gregerw/Split-flap-display/README.md

# Split-flap-display
Self-made split flap display

Find instructions how to build display at https://wordpress.com/view/splitflap.home.blog
