gregerw/Split-flap-display/CAD/flaps/flapsPlateBackside.jpg

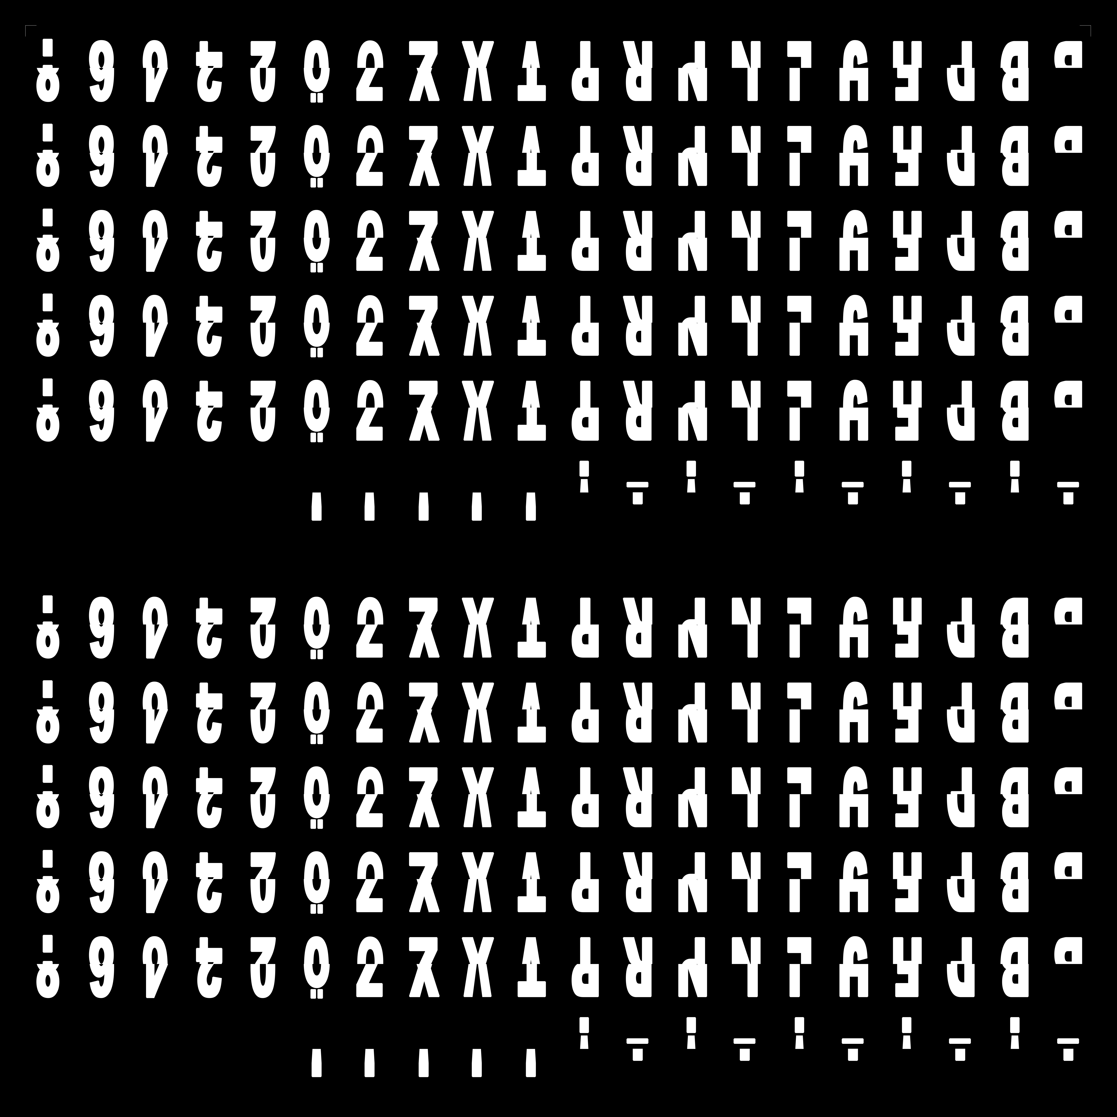
CAD/flaps/flapsPlateBackside.jpg
