gregerw/Split-flap-display/CAD/flaps/flapsPlateFrontside.jpg

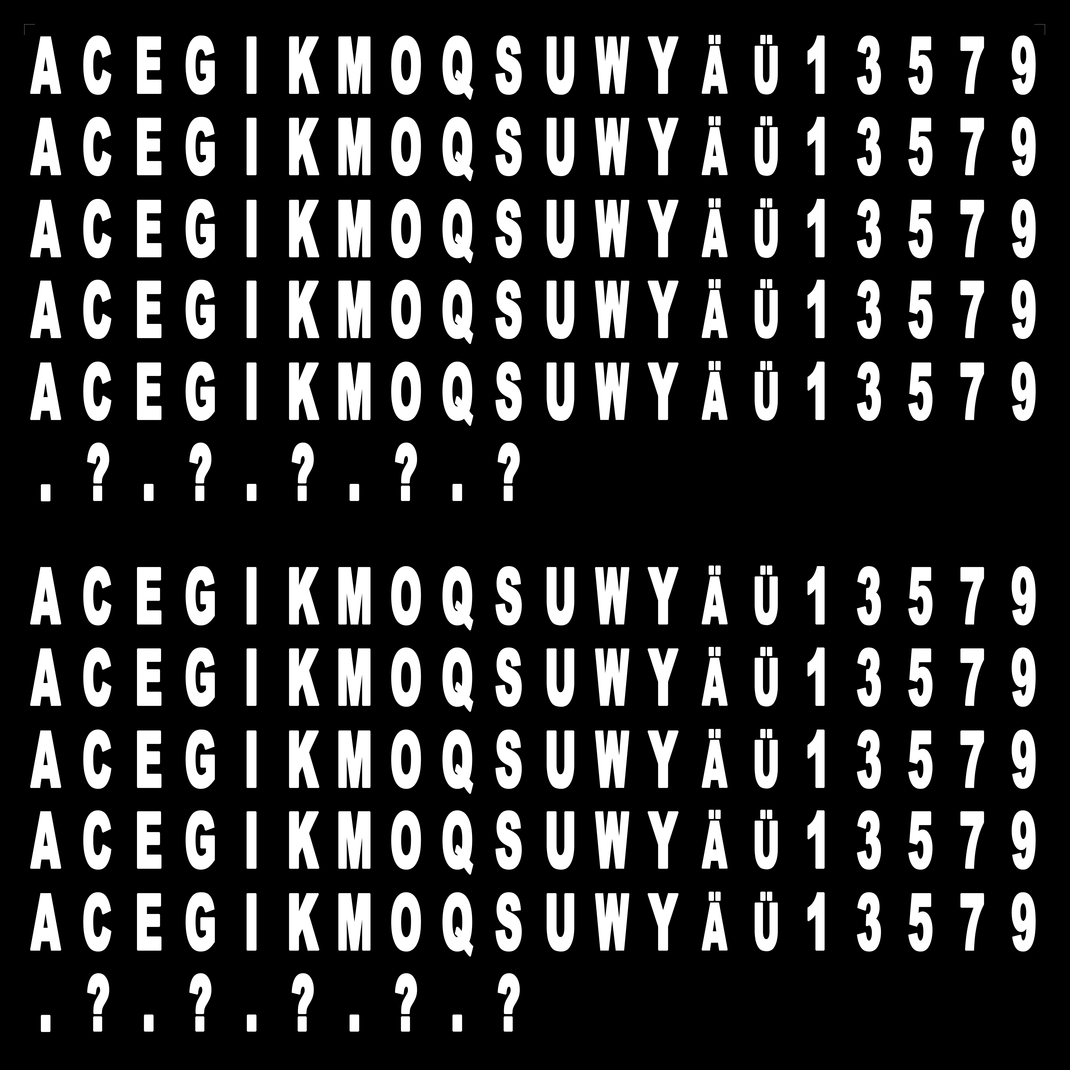
CAD/flaps/flapsPlateFrontside.jpg
