gregerw/Split-flap-display/BOM_split_flap.xlsx

Sheet: BOM_unit
Part | Part-No. | Manufacturer | Amount | Price | Reseller | Purpose of part
Step motor | 28BYJ48 12V | - | 1 | 1.19 € | https://www.aliexpress.com/item/28BYJ-48-DC-12V-Reduction-Step-Gear-Stepper-Motor-4-Phase-28byj-28byj48-for-arduino-Diy/32959155187.html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 | Rotate the revolver
Microcontroller | ATmega328P | ATMEL | 1 | 1.73 € | https://www.aliexpress.com/item/Mini-USB-Nano-V3-0-ATmega328P-CH340G-5V-16M-Micro-controller-board-for-arduino-NANO-328P/32951657212.html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 | Controller for one module/unit
PCB | unit_pcb.zip | - | 1 | 0.50 € | https://www.elecrow.com | PCB for unit
Darlington Array | ULN2003A | ST | 1 | 0.30 € | https://www.reichelt.de/darlington-arrays-konstantstromregler-dip-16-uln-2003a-p22069.html?trstct=pos_7 | Driver for stepmotor
Hall-Sensor-Module | KY-003 | Eichip | 1 | 0.17 € | https://www.aliexpress.com/item/Free-shipping-1pcs-lot-Standard-Hall-Magnetic-Sensor-Module-for-Arduino-AVR-PIC-Good-KY-003/32661635775.html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 | Angle calibration
Neodym Magnet 2mmx 1mm | F321-50 N42 | First4magnets | 1 | 0.13 € | https://www.amazon.de/dp/B007JTKHR6/ref=pe_3044161_189395811_TE_SCE_dp_2 | Magnet to calibrate rotation
DC-DC 5V | L7805CV-DG STM | Hottech | 1 | 0.27 € | https://www.reichelt.de/spannungsregler-fest-4-8-5-2-v-to-220-a-7805-p23443.html?&trstct=pos_1 | DC-DC converter 5V
Connector female | JST PH2P BU | JST | 2 | 0.05 € | https://www.reichelt.de/jst-buchsengehaeuse-1x2-polig-ph-jst-ph2p-bu-p185041.html?&trstct=pos_0 | Connector to I2C
Connector male | JST PH2P ST | JST | 2 | 0.10 € | https://www.reichelt.de/jst-stiftleiste-gerade-1x2-polig-ph-jst-ph2p-st-p185049.html?&trstct=pos_0 | Connector to I2C
Connector female | JST XH5P BU | JST | 1 | 0.04 € | https://www.reichelt.de/jst-buchsengehaeuse-1x5-polig-xh-jst-xh5p-bu-p185088.html?&trstct=pos_2 | Connector Hall-Sensor and Thermistor
Connector male | JST XH5P ST | JST | 1 | 0.17 € | https://www.reichelt.de/jst-stiftleiste-gerade-1x5-polig-xh-jst-xh5p-st-p185076.html?&trstct=pos_0 | Connector Hall-Sensor and Thermistor
Crimp for XH | JST XH CKB JST | JST | 5 | 0.03 € | https://www.reichelt.de/jst-crimpkontakt-buchse-xh-jst-xh-ckb-p185091.html?trstct=lsbght_sldr::185088 | Crimp for XH connectors
Crimp for PH | JST PH CKB | JST | 4 | 0.06 € | https://www.reichelt.de/jst-crimpkontakt-buchse-ph-jst-ph-ckb-p185071.html?&trstct=pos_0 | Crimp for PH connectors
Connector Stepmotor | JST XH5P ST | JST | 1 | 0.22 € | https://www.reichelt.de/jst-stiftleiste-gerade-1x5-polig-xh-jst-xh5p-st-p185076.html?&trstct=pos_0 | Connector to Stepmotor
Connector 12V male | AKL 230-02 | AKL | 1 | 0.28 € | https://www.reichelt.de/wannenstecker-fuer-akl-249-2-pol-rm5-08-akl-230-02-p36701.html? | Connector to 12V
Connector 12V female | AKL 249-02 | AKL | 1 | 0.57 € | https://www.reichelt.de/anschlussklemmensystem-2-pol-rm5-08-akl-249-02-p36686.html?&trstct=pos_0 | Connector to 12V
Thermistor 100K; B3950K | NTC Thermistor 100k B3950K | - | 1 | 0.25 € | https://www.ebay.de/i/112050606664?chn=ps | Thermistor for temperature measurement
Resistor 100k | 100k, 0.6W | - | 1 | 0.04 € | https://www.reichelt.de/duennschichtwiderstand-axial-0-6-w-100-kohm-1-vi-mbb02070c1003-p233667.html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 | Reference resistor for thermistor
Housing Screws, Torx, counter sunk | Screw PT K25, 10 | PT | 15 | 0.06 € | https://www.online-schraubenhandel.de/price.php?group_id=71 | Screws for housing and motorblock
PCBA Screws, Torx, raised head | Screw PT K25, 6 | PT | 4 | 0.14 € | https://www.ebay.de/itm/25-PT-Schrauben-f-Kunststoffe-Linsenkopf-Torx-A2-2-5X6-Thermoplaste-rostfrei/401004178857 | Screws to fix the PCBA on the rear side
Front-Panel | front_panel.gcode | - | 1 | 0.17 € | https://www.amazon.de/ELEGOO-Filament-Drucker-Printer-Toleranz/dp/B07K1MCSCQ | Plastic parts printed via e.g. Anycubic i3
Rear-Panel | rear_panel.gcode | - | 1 | 0.19 € | https://www.amazon.de/ELEGOO-Filament-Drucker-Printer-Toleranz/dp/B07K1MCSCQ | Plastic parts printed via e.g. Anycubic i3
Left-Panel | left_panel.gcode | - | 1 | 0.34 € | https://www.amazon.de/ELEGOO-Filament-Drucker-Printer-Toleranz/dp/B07K1MCSCQ | Plastic parts printed via e.g. Anycubic i3
Right-Panel | right_panel.gcode | - | 1 | 0.32 € | https://www.amazon.de/ELEGOO-Filament-Drucker-Printer-Toleranz/dp/B07K1MCSCQ | Plastic parts printed via e.g. Anycubic i3
Motorblock | motorblock.gcode | - | 1 | 0.22 € | https://www.amazon.de/ELEGOO-Filament-Drucker-Printer-Toleranz/dp/B07K1MCSCQ | Plastic parts printed via e.g. Anycubic i3
Revolver Left | revolver_left.gcode | - | 1 | 0.27 € | https://www.amazon.de/ELEGOO-Filament-Drucker-Printer-Toleranz/dp/B07K1MCSCQ | Plastic parts printed via e.g. Anycubic i3
Revolver Right | revolver_right.gcode | - | 1 | 0.51 € | https://www.amazon.de/ELEGOO-Filament-Drucker-Printer-Toleranz/dp/B07K1MCSCQ | Plastic parts printed via e.g. Anycubic i3
Flaps | flaps.pdf, flaps.svg | - | 45 | 0.10 € | http://xlprint24.de | Polypropylene 1mm plate, printed both sides; Lasercutted
 |  | Total costs per unit |  | 14.47 €

Sheet: BOM_master
Part | Part-No. | Manufacturer | Amount | Price | Reseller | Purpose of part
Microcontroller | ATmega328P | ATMEL | 1 | 1.73 € | https://www.aliexpress.com/item/Mini-USB-Nano-V3-0-ATmega328P-CH340G-5V-16M-Micro-controller-board-for-arduino-NANO-328P/32951657212.html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 | Controller for master
Wifi-Module | ESP8266 ESP01 | Espressif | 1 | 1.23 € | https://www.aliexpress.com/item/Free-Shipping-ESP8266-ESP-01S-ESP-01-Wireless-Transceiver-Module-With-Breakout-Breadboard-Adapter/32770549691.html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 | Wifi-module
PCB | master_pcb.zip | - | 1 | 0.50 € | https://www.elecrow.com | PCB for master
DC-DC 5V | L7805CV-DG STM | Hottech | 1 | 0.27 € | https://www.reichelt.de/spannungsregler-fest-4-8-5-2-v-to-220-a-7805-p23443.html?&trstct=pos_1 | 5V for Arduino and for DC-DC 3,3V
DC-DC 3,3V | LM3940 | TI | 1 | 1.40 € | https://www.reichelt.de/ldo-regler-fest-3-3-v-to-220-lm-3940-it3-3-p39464.html? | 3,3V for ESP8266
MOSFET | 2N7000 | UTC | 2 | 0.09 € | https://www.reichelt.de/mosfet-n-ch-60v-0-115a-0-4w-to-92-2n-7000-p41141.html? | Part of the 5V/3,3V bidirectional level shifter
Resistor 4,7k 0207 | 4k7, 0207 | - | 2 | 0.08 € | https://www.reichelt.de/widerstand-metallschicht-4-75-kohm-0207-0-6-w-1-metall-4-75k-p11786.html? | Part of the 5V/3,3V bidirectional level shifter
Resistor 2k 0207 | 2k, 0207 |  | 2 | 0.08 € | https://www.reichelt.de/widerstand-metallschicht-2-00-kohm-0207-0-6-w-1--metall-2-00k-p11578.html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 | Pull-up for I2C
Resistor 10k 0207 | 10k, 0207 | - | 4 | 0.08 € | https://www.reichelt.de/widerstand-metallschicht-10-0-kohm-0207-0-6-w-1-metall-10-0k-p11449.html? | Part of the 5V/3,3V bidirectional level shifter
Capacitor 100nF | X7R-5 100N | - | 2 | 0.10 € | https://www.reichelt.de/vielschicht-keramikkondensator-100n-10-x7r-5-100n-p22865.html?&trstct=pos_0 | Capacitor to stabalize supply voltage
Connector male | JST PH2P ST | JST | 2 | 0.10 € | https://www.reichelt.de/jst-stiftleiste-gerade-1x2-polig-ph-jst-ph2p-st-p185049.html?&trstct=pos_0 | Connector to I2C
Connector 12V male | AKL 230-02 | AKL | 1 | 0.28 € | https://www.reichelt.de/wannenstecker-fuer-akl-249-2-pol-rm5-08-akl-230-02-p36701.html? | Connector to 12V
Connector 12V female | AKL 249-02 | AKL | 1 | 0.57 € | https://www.reichelt.de/anschlussklemmensystem-2-pol-rm5-08-akl-249-02-p36686.html?&trstct=pos_0 | Connector to 12V
 |  | Total costs per unit |  | 7.20 €
