gregerw/Split-flap-display/CAD/housing_side_right.STL

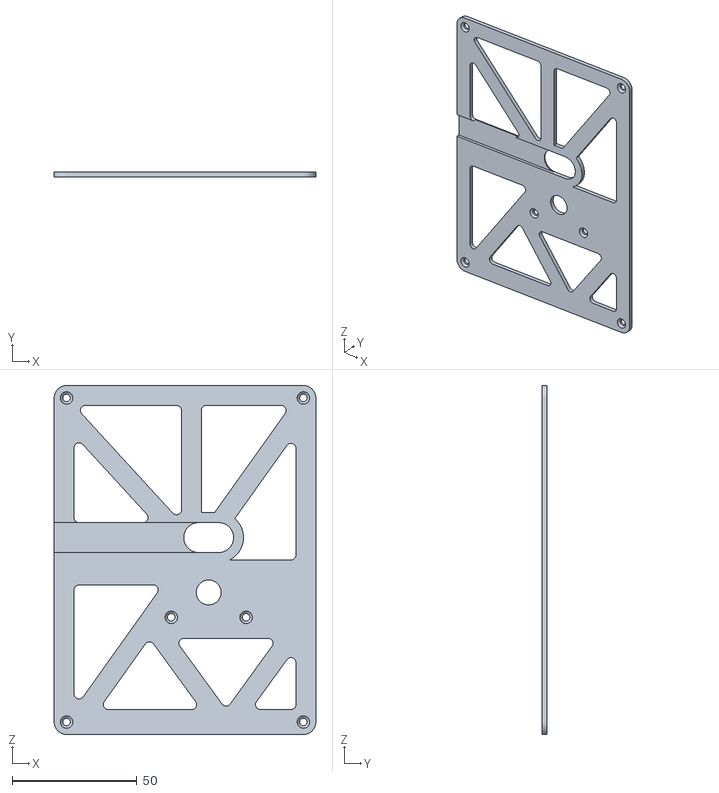
[picture p3: CAD file, 2019-05-17]
CAD/housing_side_right.STL
105.0 x 2.00 x 140.0
