gregerw/Split-flap-display/CAD/motorblock.STL

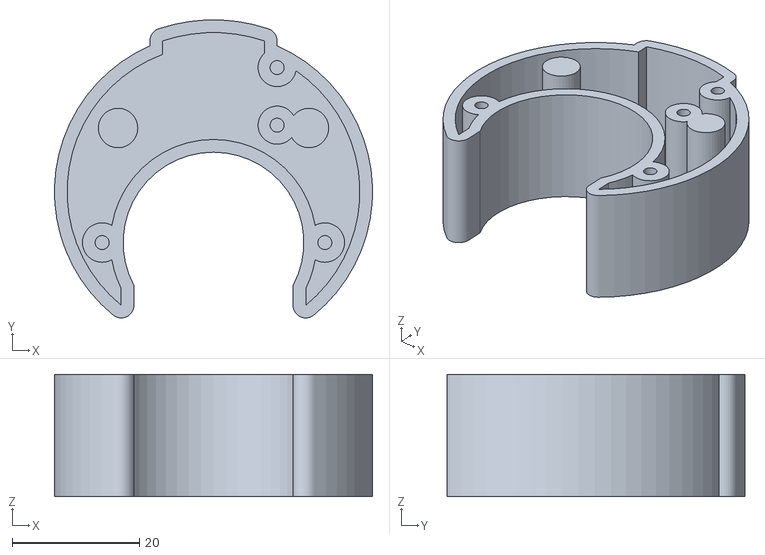
[picture p4: CAD file, 2019-05-17]
CAD/motorblock.STL
50.0 x 46.8 x 19.2
