gregerw/Split-flap-display/CAD/revolver_left.STL

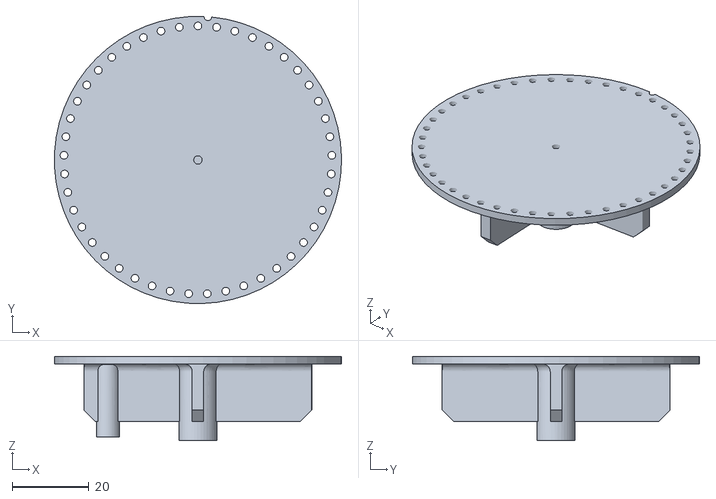
[picture p5: CAD file, 2019-05-17]
CAD/revolver_left.STL
74.9 x 74.9 x 22.0
