gregerw/Split-flap-display/CAD/revolver_right.STL

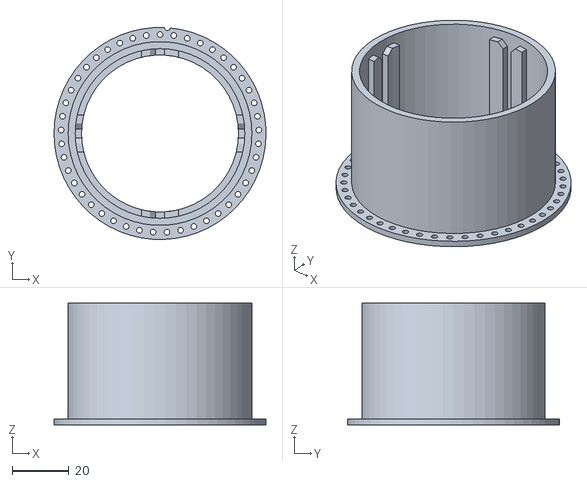
[picture p6: CAD file, 2019-05-17]
CAD/revolver_right.STL
75.0 x 74.9 x 43.0
