gregerw/Split-flap-display/CAD/housing_front.STL

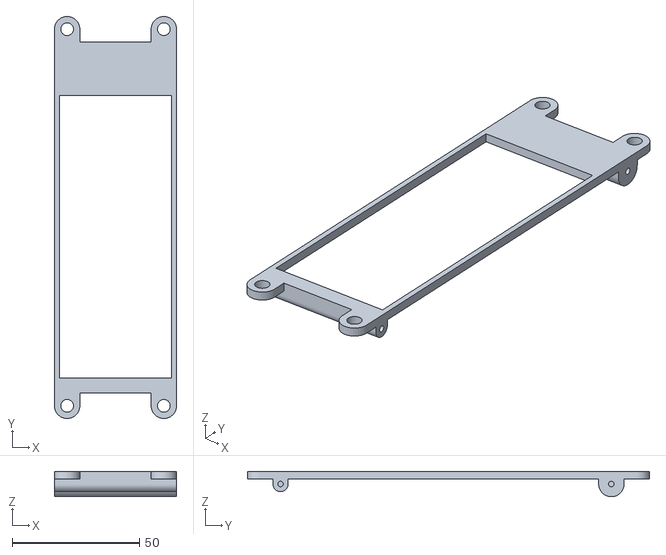
[picture p7: CAD file, 2019-05-17]
CAD/housing_front.STL
48.0 x 158.0 x 9.98
