gregerw/Split-flap-display/CAD/housing_back.STL

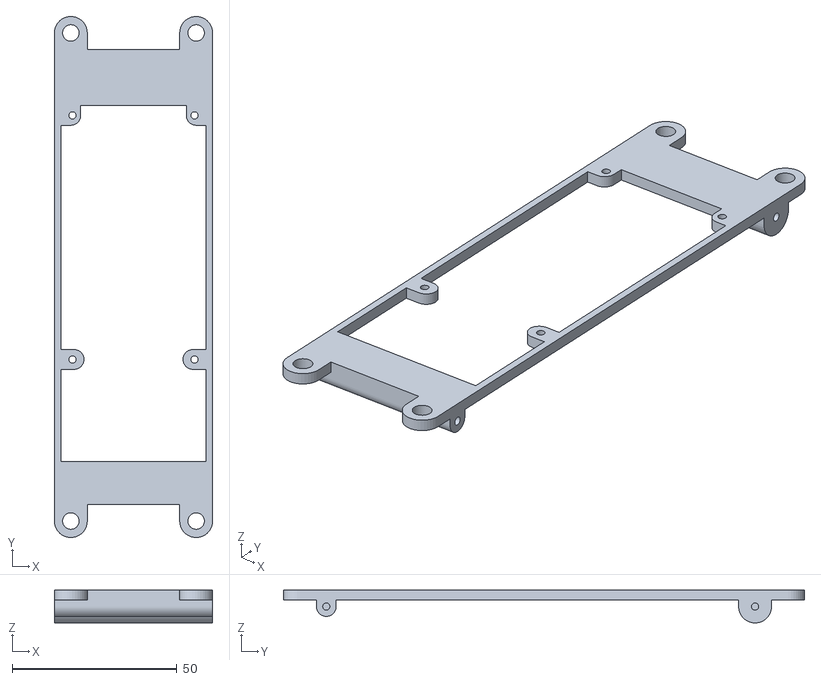
[picture p8: CAD file, 2019-05-17]
CAD/housing_back.STL
48.0 x 158.0 x 9.98
