gregerw/Split-flap-display/(list of files, cad)

Other CAD files:
CAD/housing_side_left.STL
