gregerw/Split-flap-display/(threads)

Thread 1 (2020-09-07):

https://wordpress.com/view/splitflap.home.blog not working

clankill3r, 2020-09-07:
Hi, your project seems really nice.
Unfortunately I don't see any instructions at https://wordpress.com/view/splitflap.home.blog.

I guess this is the same: https://splitflap.home.blog/

NightmindOfficial, 2021-04-26:
Can confirm.
https://splitflap.home.blog/ is reachable and has instructions / overview of the project

Balurd116, 2021-05-01:
I am trying to order the PCBs but they ask me a lot of information such as layers, thickness etc .... what should I do? Can You help me please ?

Thread 6 (2022-05-29):

Error compiling for board arduino nano //master

BongHole, 2022-05-29:
Hi

I am sorry but I have not really knowledge about prograsmming but I got a little problem here

when I try to flash the master I will get this error

In file included from C:\Users\BongHole\Desktop\Projekt\code\master\master\master.ino:14:0:
C:\Program Files (x86)\Arduino\libraries\Timezone/Timezone.h:11:13: error: token "=" is not valid in preprocessor expressions
 #if ARDUINO = 100
             ^
C:\Program Files (x86)\Arduino\libraries\Timezone/Timezone.h:14:10: error: #include expects "FILENAME" or <FILENAME>
 #include WProgram.h
          ^~~~~~~~
C:\Program Files (x86)\Arduino\libraries\Timezone/Timezone.h:16:10: error: #include expects "FILENAME" or <FILENAME>
 #include TimeLib.h     httpsgithub.comPaulStoffregenTime
          ^~~~~~~
exit status 1
Error compiling for board Arduino Nano.

could someone help me with that?

greetings

BongHole, 2022-06-01:
I found the error

i installed the timezone.h by hand...
when I tried it via libraries manager it worked!

Closed 2022-06-01.

Thread 7 (2022-06-13):

help with master unit

BongHole, 2022-06-13:
Hello,

I try to build one of this displays since moths...

I made now a third master unit but it still doesn't work,,,

1st try I used the wrong parts
2nd try I couldn't flash the ESP to 9600
3nd try the ESP is not working at all (no led)

so is here maybe someone who build on of this master units?

maybe I could send you the parts and you build it for me?

would be nice if there is one of you who could help me!

thank you

jazz-g, 2023-07-08:
Did you ever figure it out?

I'm trying to figure out which resistors go where, and which linear voltage regulators go where.
