gregerw/Split-flap-display/CAD/flaps/flapDrawing.PDF

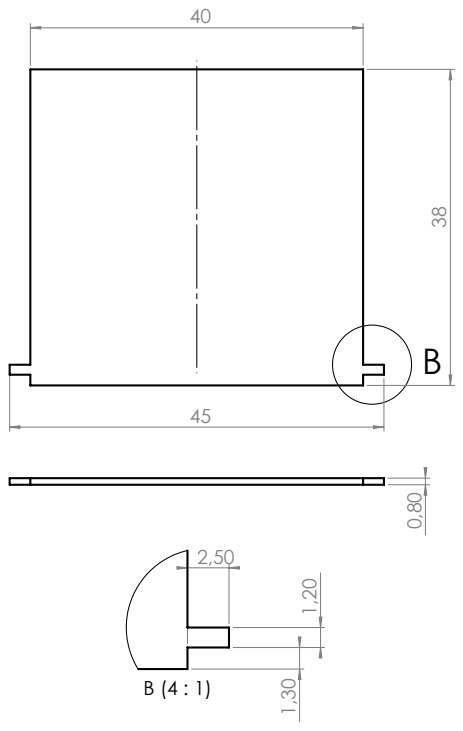
[picture p9: page 1]
