gregerw/Split-flap-display/PCB/unit_schematic_1_1.brd

## EAGLE design PCB/unit_schematic_1_1.brd (2019-05-17)

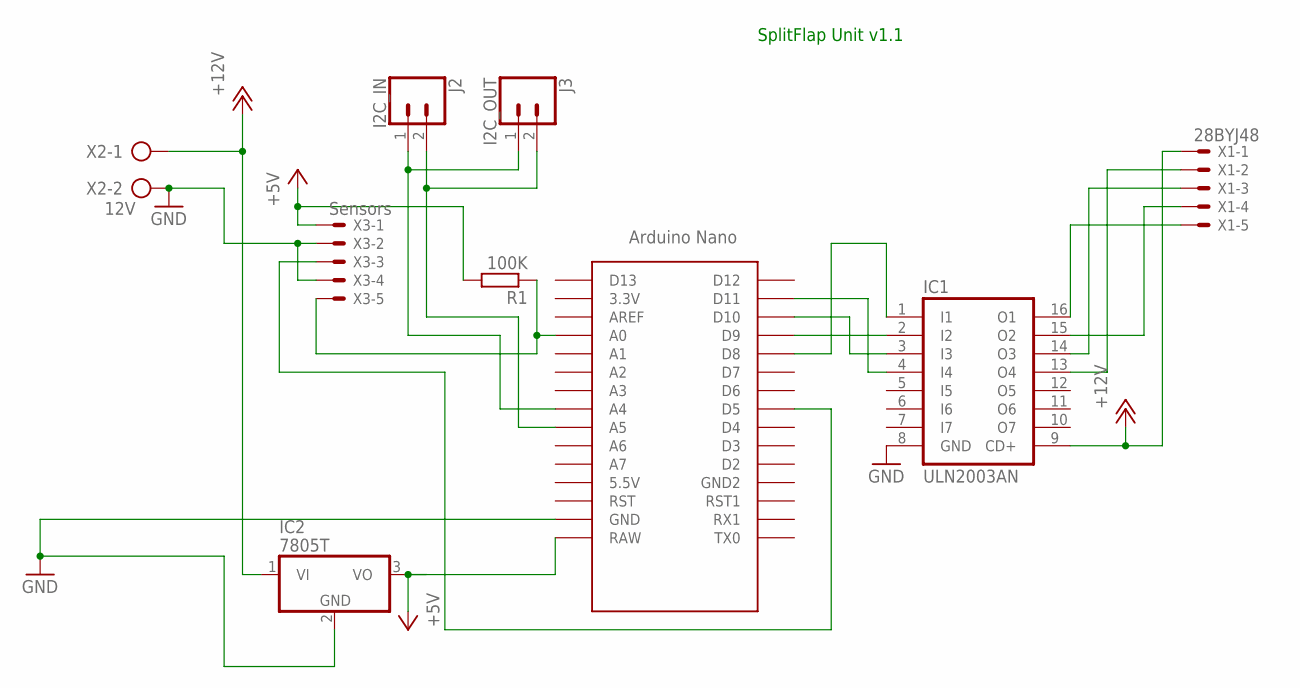
[picture p10: schematic unit_schematic_1_1.sch]

Parts:
IC1: ULN2003AN; DIL16
IC2: 7805T; TO220H
J2: I2C_IN; JST-2-PTH
J3: I2C_OUT; JST-2-PTH
R1: 100K; 0207/10
U$2: NANO
X1: 28BYJ48; JST-XH-05-PACKAGE-ROUND-PAD
X2: 12V; AK300/2
X3: Sensors; JST-XH-05-PACKAGE-ROUND-PAD

Connections:
+5V: IC2.3 (VO), R1.2, U$2.RAW, X3.1
+12V: IC1.9 (CD+), IC2.1 (VI), X1.1, X2.1
GND: IC1.8 (GND), IC2.2 (GND), U$2.GND, X2.2, X3.2, X3.4
unnamed: IC1.1 (I1), U$2.D8
unnamed: R1.1, U$2.A0, X3.5
unnamed: IC1.2 (I2), U$2.D9
unnamed: IC1.3 (I3), U$2.D10
unnamed: IC1.4 (I4), U$2.D11
unnamed: IC1.13 (O4), X1.2
unnamed: IC1.14 (O3), X1.3
unnamed: IC1.15 (O2), X1.4
unnamed: IC1.16 (O1), X1.5
unnamed: U$2.D5, X3.3
unnamed: J2.2, J3.2, U$2.A5
unnamed: J2.1, J3.1, U$2.A4

Notes on the sheet:
SplitFlap Unit v1.1

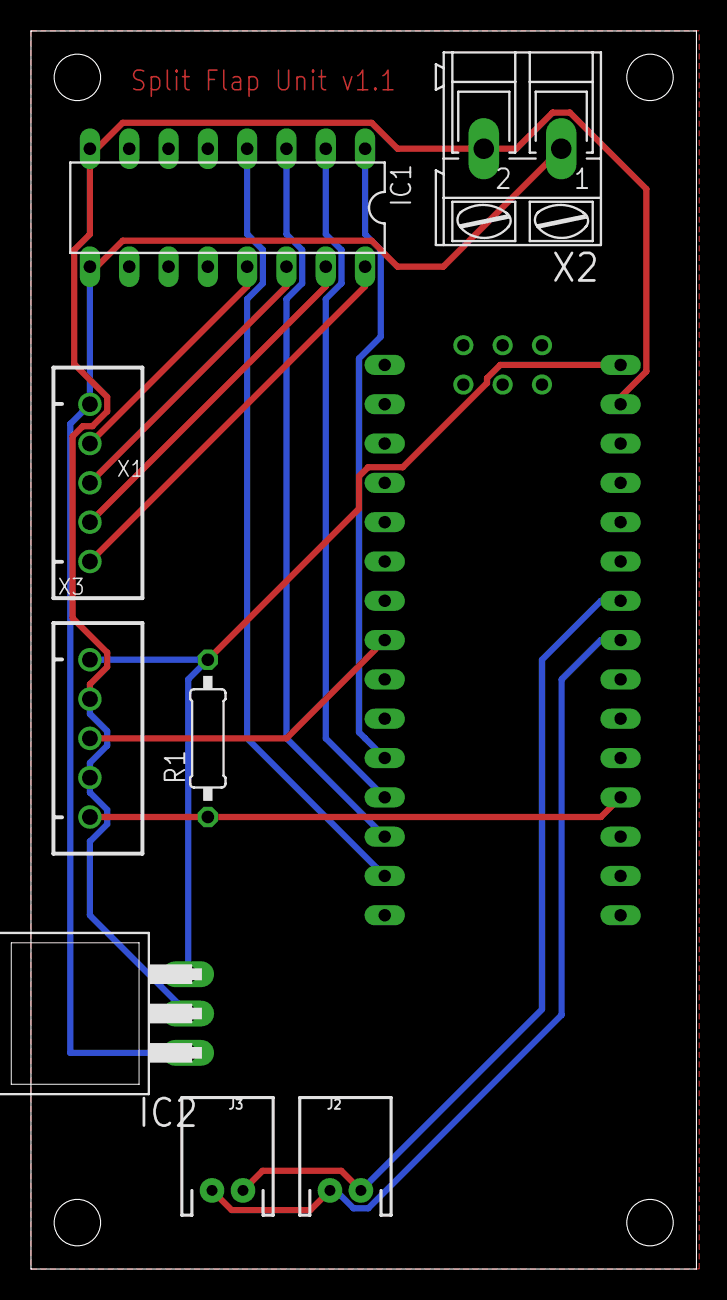
[picture p11: board unit_schematic_1_1.brd from above]

Board: 2 copper layers, 43.0 x 80.0 mm, 9 parts (0 on the bottom side), 15 nets.
