gregerw/Split-flap-display/PCB/master_schematic.brd

## EAGLE design PCB/master_schematic.brd (2019-05-17)

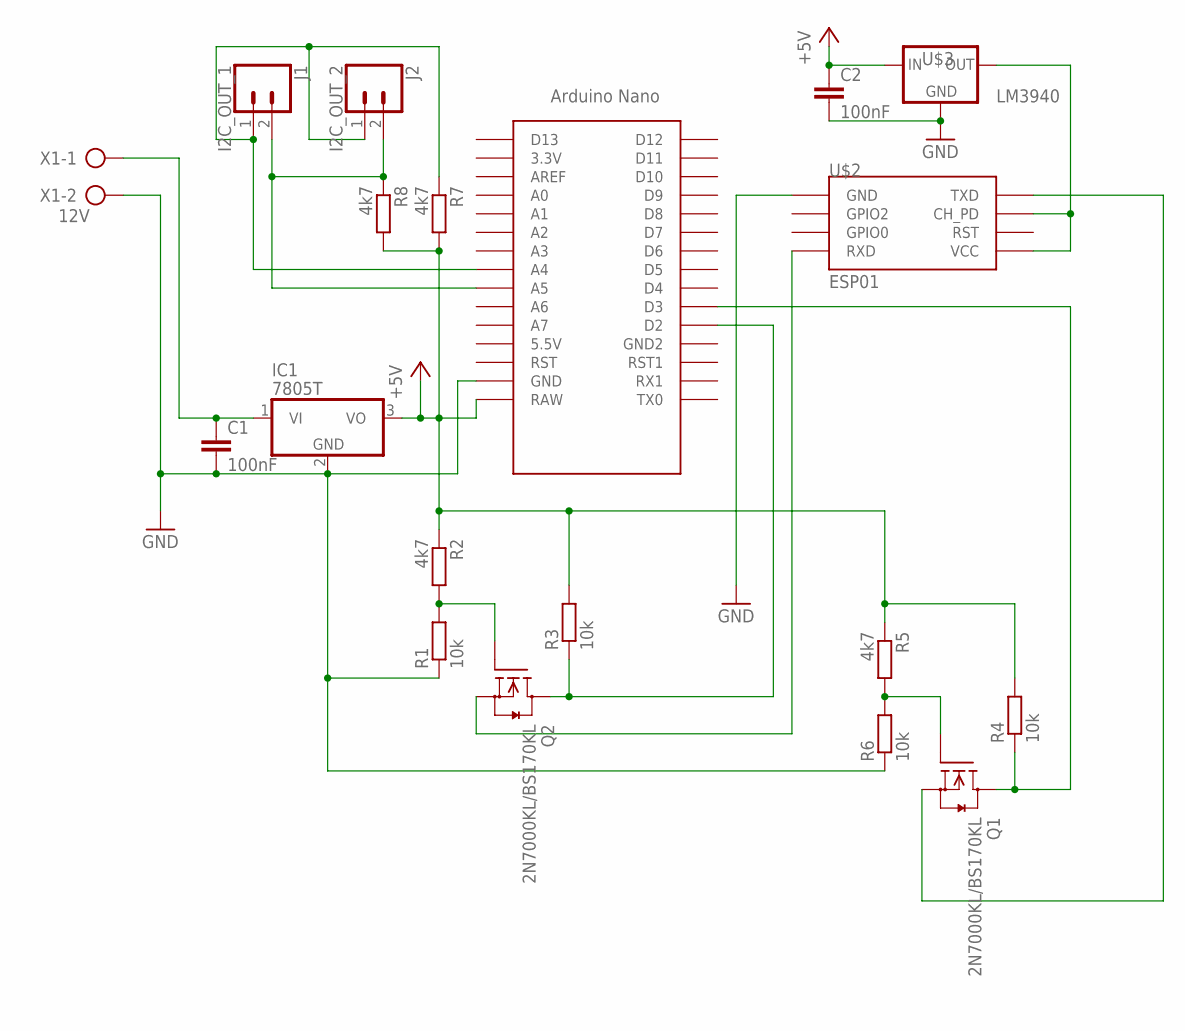
[picture p12: schematic master_schematic.sch]

Parts:
C1, C2: 100nF; C025-030X050
IC1: 7805T; TO220H
J1: I2C_OUT_1; JST-2-PTH
J2: I2C_OUT_2; JST-2-PTH
Q1, Q2: 2N7000KL/BS170KL; TO92
R1, R3, R4, R6: 10k; 0207/10
R2, R5, R7, R8: 4k7; 0207/10
U$1: NANO
U$2: ESP01
U$3: LM3940; TO220
X1: 12V; AK300/2

Connections:
+5V: C2.1, IC1.3 (VO), R2.1, R3.2, R4.2, R5.1, R7.2, R8.2, U$1.RAW, U$3.1 (IN)
GND: C1.2, C2.2, IC1.2 (GND), R1.1, R6.1, U$1.GND, U$2.GND, U$3.2 (GND), X1.2
unnamed: J1.1, J2.1, R7.1, U$1.A4
unnamed: J1.2, J2.2, R8.1, U$1.A5
unnamed: C1.1, IC1.1 (VI), X1.1
unnamed: Q2.1 (S), U$2.RX (RXD)
unnamed: Q2.2 (G), R1.2, R2.2
unnamed: U$2.CH_PD, U$2.VCC, U$3.3 (OUT)
unnamed: Q1.2 (G), R5.2, R6.2
unnamed: Q1.3 (D), R4.1, U$1.D3
unnamed: Q2.3 (D), R3.1, U$1.D2
unnamed: Q1.1 (S), U$2.TX (TXD)

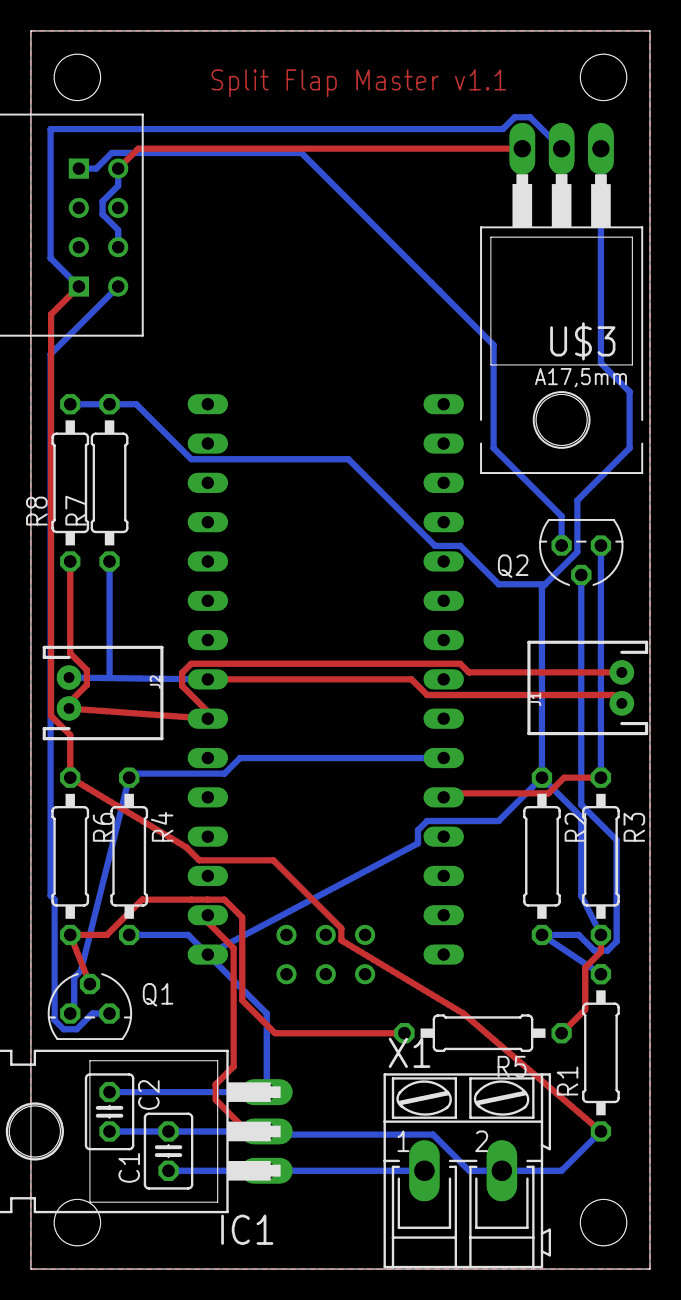
[picture p13: board master_schematic.brd from above]

Board: 2 copper layers, 40.0 x 80.0 mm, 19 parts (0 on the bottom side), 12 nets.
