gregerw/Split-flap-display/Software/iOS_UDP_Client/gMessage/gMessage/AppDelegate.h

//
//  AppDelegate.h
//  gMessage
//
//  Created by Walter Greger on 26.02.19.
//  Copyright © 2019 Walter Greger. All rights reserved.
//

#import <UIKit/UIKit.h>

@interface AppDelegate : UIResponder <UIApplicationDelegate>

@property (strong, nonatomic) UIWindow *window;


@end
