gregerw/Split-flap-display/(commit log)

2019-03-03 Update BOM_split_flap.xlsx
    fixed some entries
    [BOM_split_flap.xlsx]
2019-03-05 initial upload
    [master_schematic.brd, master_schematic.sch, unit_schematic.brd, unit_schematic.sch]
2019-05-17 Update BOM_split_flap.xlsx
    Added components for v1.1
    [BOM_split_flap.xlsx]
2019-05-17 new versions of pcb
    [master_schematic.brd, master_schematic.sch, unit_schematic.sch, unit_schematic_1_1.brd, unit_schematic_1_1.sch]
2019-05-17 CAD files for unit
    [housing_back.STL, housing_front.STL, housing_side_left.STL, housing_side_right.STL, motorblock.STL, revolver_left.STL, revolver_right.STL]
2019-05-18 is not part of the cad lib
2019-05-18 not part of pcba files
